KafkaPatrik/Arduino-Ball-Color-Sorting-System/README.md

# Arduino-Ball-Color-Sorting-System
System for sorting balls by color using arduino
