KafkaPatrik/Arduino-Ball-Color-Sorting-System/Arhitectura_Sistemului.pdf

## ARDUINO UNO

## NEMA17

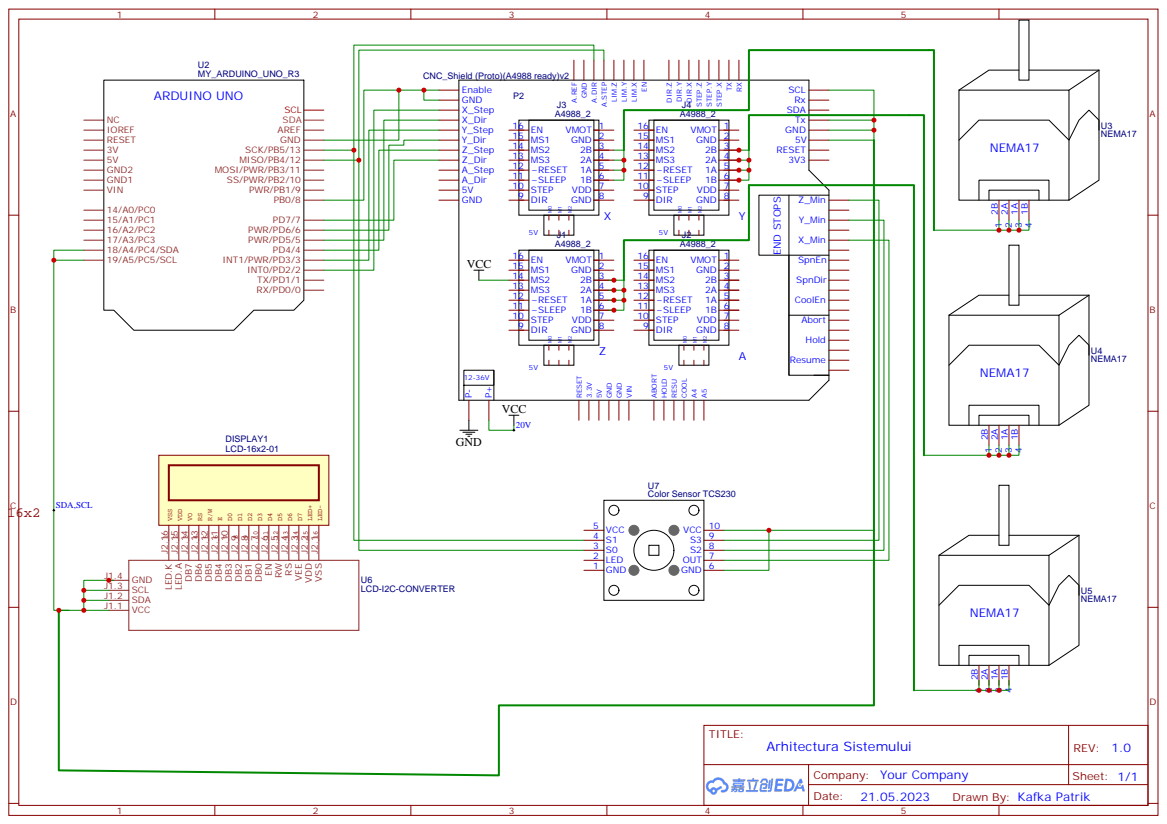
[picture p22: page 1]

STEP 10 ~SLEEP 11 ~RESET 12 MS3 13 MS2 14 MS1 15 EN 16

VSS J2.1 VDD J2.2 VEE J2.3 RS J2.4 RW J2.5

Drawn By: Kafka Patrik
